atireksd11/Astra-Companion-NOISEEE/docs/README.md

# Docs

| File | Contents |
|---|---|
| [AUDIO.md](AUDIO.md) | WebSocket audio protocol and robot firmware modules |
| [VOICE_SETUP.md](VOICE_SETUP.md) | Laptop bridge, wake word, and STT |
| [ROADMAP_AUDIO.md](ROADMAP_AUDIO.md) | Full audio feature order |
| [FEATURE4_NOISE.md](FEATURE4_NOISE.md) | Noise floor and denoise |
| [FEATURE3_DOA.md](FEATURE3_DOA.md) | Direction of arrival |
| [PINOUT.md](PINOUT.md) | GPIO map including I2S |
| [images/](images/) | PCB and audio module CAD renders |

Mechanical BOM: [../hardware/BOM_AUDIO_MODULE.md](../hardware/BOM_AUDIO_MODULE.md).
