atireksd11/Astra-Companion-NOISEEE/TERRA_CONTEXT.md

# Astra Companion & Terra Project Master Context

## 1. Developer Profile & Working Style
- **Age**: 14 years old (high-school builder & programmer).
- **Primary Tools**: Cursor IDE, CAD tools (ragnar.build, zoo.dev), GitHub (`atireksd11`).
- **Work Ethic**: Intense deep-work sprints (up to 17–18 hours during weekend project blocks), structured phase-based workflows, rigorous mechanical/software engineering (CAD component envelopes, electrical docking, wire routing).
- **Schedule Constraints**: Plays cricket every Sunday from 5:00 PM to 8:00 PM. Also organizing a high-school hackathon for 50–100 participants at the University of Toronto (St. George, UTM, UTSC) on November 14–15, 2026.

---

## 2. Hack Club Terra Program & Goals
- **Program**: Hack Club Terra Software YSWS (Active: October 2026 – January 2027).
- **Target Reward**: iPad Mini (A17 Pro) to serve as a portable companion device for datasheets, schematics, and mobile notes.
- **Primary Hardware**: MSI Cyborg (heavy gaming laptop used for heavy CAD builds and local compilation).
- **Current Sprint**: Week 2. Executing a massive 20-hour manual coding sprint in VS Code / Hackatime to clear rent/debt, secure safety margins in the Terra dashboard, and maintain a pristine record.

---

## 3. Strict Compliance & Anti-AI Policy
- **Background**: Previous *Half-Life* hardware grant applications faced rejections due to AI tool usage. Admins confirmed the account is in good standing for *Terra*, but under zero-tolerance conditions.
- **Rules**: 
  - 100% manual, line-by-line human-written code only.
  - Zero AI code generation, zero AI transcription tools, zero automated prompt pasting into production codebases.
  - Hackatime telemetry must strictly mirror active human keystrokes and manual git commits.

---

## 4. Active Technical Project: Astra-Companion-NOISEEE
- **Repository**: `atireksd11/Astra-Companion-NOISEEE` (C++, Robotics / Self-Balancing AI Robot).
- **Project Scope**: Multi-phase modular robot featuring a servo-controlled neck mechanism, removable audio module enclosure, 3D-printed housing, and self-balancing mechanics.
- **Current Milestone**: Phase 0 & Phase 1 completed (bug fixes and CAD assemblies finalized). Transitioning into active software implementation for the Terra sprint.
