atireksd11/Astra-Companion-NOISEEE/docs/images/cad-pcb-stack.png

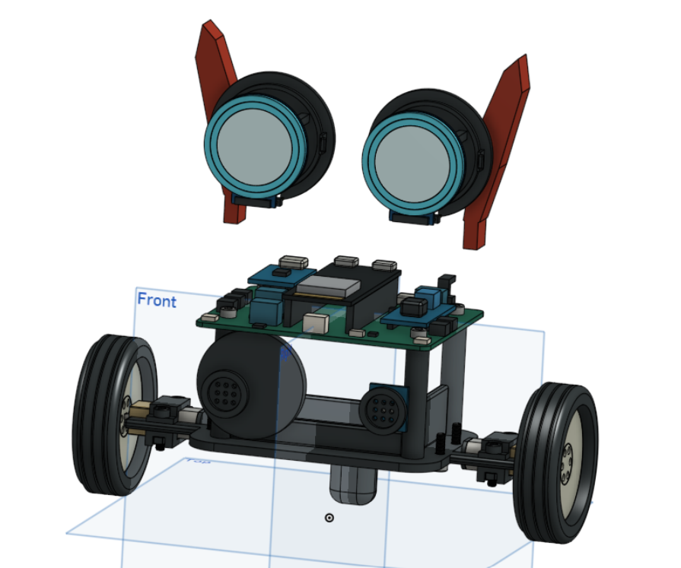
docs/images/cad-pcb-stack.png
