atireksd11/Astra-Companion-NOISEEE/BOM.csv

Item | Qty | Supplier | Cost/item | Total Cost | link
PGN 608-ZZ Ball Bearings (10-pack) | 10 | Amazon.ca | $1.295 | $12.95 | https://www.amazon.ca/gp/product/B07XLV1W2M/ref=ox_sc_act_title_2?smid=A3RMJZMAP3U4RK&psc=1
MG90S Metal Gear Micro Servo (2-pack) | 2 | Amazon.ca | $7.495 | $14.99 | https://www.amazon.ca/gp/product/B0BHYHKF2P/ref=ox_sc_act_title_1?smid=A1AEYBYG92X8UY&psc=1
Estimated total shipping | 1 |  |  | $5.00
