atireksd11/Astra-Companion-NOISEEE/cad/robot-torso-audio-backpack.step

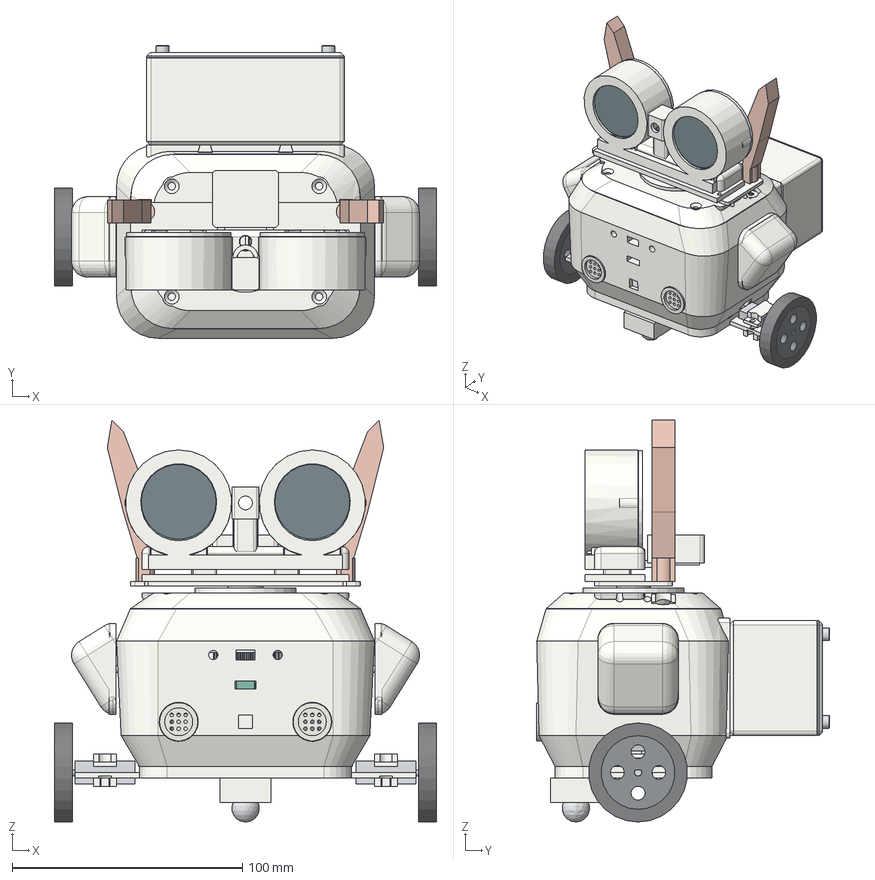
[picture p10: CAD file, 2026-10-26]
cad/robot-torso-audio-backpack.step
166.0 x 127.0 x 174.5 mm
Main torso — reinforced female docking wall
Left removable side pod
Right removable side pod
Front speaker grille
Front microphone grille
Lower chassis and battery pocket
Front frosted diffuser
Removable power and drive electronics deck
Neck service cover — cartridge opening
Front 12 mm ball caster socket
12 mm metal caster ball
TP4056 + DW01 protection — provisional PCB
MT3608 boost converter — provisional PCB
DRV8833 motor driver — provisional PCB
AP2112K 3V3 carrier — provisional PCB
MAX17048 fuel gauge carrier — provisional PCB
MAX98357A amplifier — provisional PCB
Dual bearing cartridge body
Lower bearing retaining plate
Upper bearing retainer and cover flange
Steel hollow shaft — 8 OD x 5 ID x 40
OuterRace x 2
InnerRace x 2
Cap x 4
Inner race spacer 8 mm
26T driven gear — split shaft clamp
26T servo horn gear — 1 to 1
MG90S servo — provisional supplier envelope
Offset MG90S suspended mounting frame
Purchased MG90S horn envelope — verify hole pitch
Rotating head and ear cradle — split shaft collar
Dual eye carrier — GC9A01 seats
Left eye rear cap
Right eye rear cap
Left ear
Right ear
IMU protective cover — retention fit to validate
Left GC9A01 PCB envelope
Left 1.28 inch LCD glass
Right GC9A01 PCB envelope
Right 1.28 inch LCD glass
MPU6050 PCB envelope
Left N20 upper clamp
Left N20 lower cradle
Left N20 6V 300RPM — shaft variant provisional
Left 43 mm rubber tire
Left wheel hub — 3 mm D-bore provisional
Right N20 upper clamp
Right N20 lower cradle
Right N20 6V 300RPM — shaft variant provisional
Right 43 mm rubber tire
Right wheel hub — 3 mm D-bore provisional
Audio pod base — dovetails, carriers and lock
Audio pod vented lid — six slots and four-hole grille
Speaker retention bridge
Split wire grommet — TPU or purchased equivalent
ESP32-S3 62.7 x 25.4 PCB envelope
INMP441 PCB envelope
28 mm speaker envelope
thread x 5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
