atireksd11/Astra-Companion-NOISEEE/JOURNAL.md

# Astra Companion – devlog

<!-- Generated by Half Life from project cmveqgniy09tv01rcokxzpry2. Edits here are overwritten on the next sync. -->
<!-- Generated: 2026-10-25T20:34:38.114Z -->

> [!NOTE]
> This devlog is mirrored from [Half Life](https://halflife.hackclub.com) – [open the project](https://halflife.hackclub.com/projects/cmveqgniy09tv01rcokxzpry2). Editing it here will not change the platform's copy, and the next sync overwrites this file.

> A 2-wheeler, self-balancing, smart robot powered by an ESP32-S3-DevKitC-1 module. It integrates sensor arrays (such as the MPU6050 IMU and DS3231 RTC), motor drivers (DRV8833PWP), local storage (MicroSD card), user input controls (tactile buttons and rotary encoders), and power management to create a smart robot.

| Week | Tier | Hours logged | Entries |
| --- | --- | --- | --- |
| Week 3 | Tier 1 | 19.37h | 2 |

## Contents

1. [2026-10-24 – Work session](#2026-10-24-work-session)
2. [2026-10-25 – Work session](#2026-10-25-work-session)

## Design

### 2026-10-24 – Work session

**9.05h**

[Timelapse](https://lookout.hackclub.com/api/media/45e28134-6914-488f-8e3e-f000de63a018/video.mp4)

### 2026-10-25 – Work session

**10.32h**

[Timelapse](https://lookout.hackclub.com/api/media/6f72a879-5bdd-47c9-9e10-55bd97b0e4b6/video.mp4)
