atireksd11/Astra-Companion-NOISEEE/hardware/astracompanion/astracompanion.kicad_pcb

## KiCad design hardware/astracompanion/astracompanion.kicad_pcb (2026-10-26)

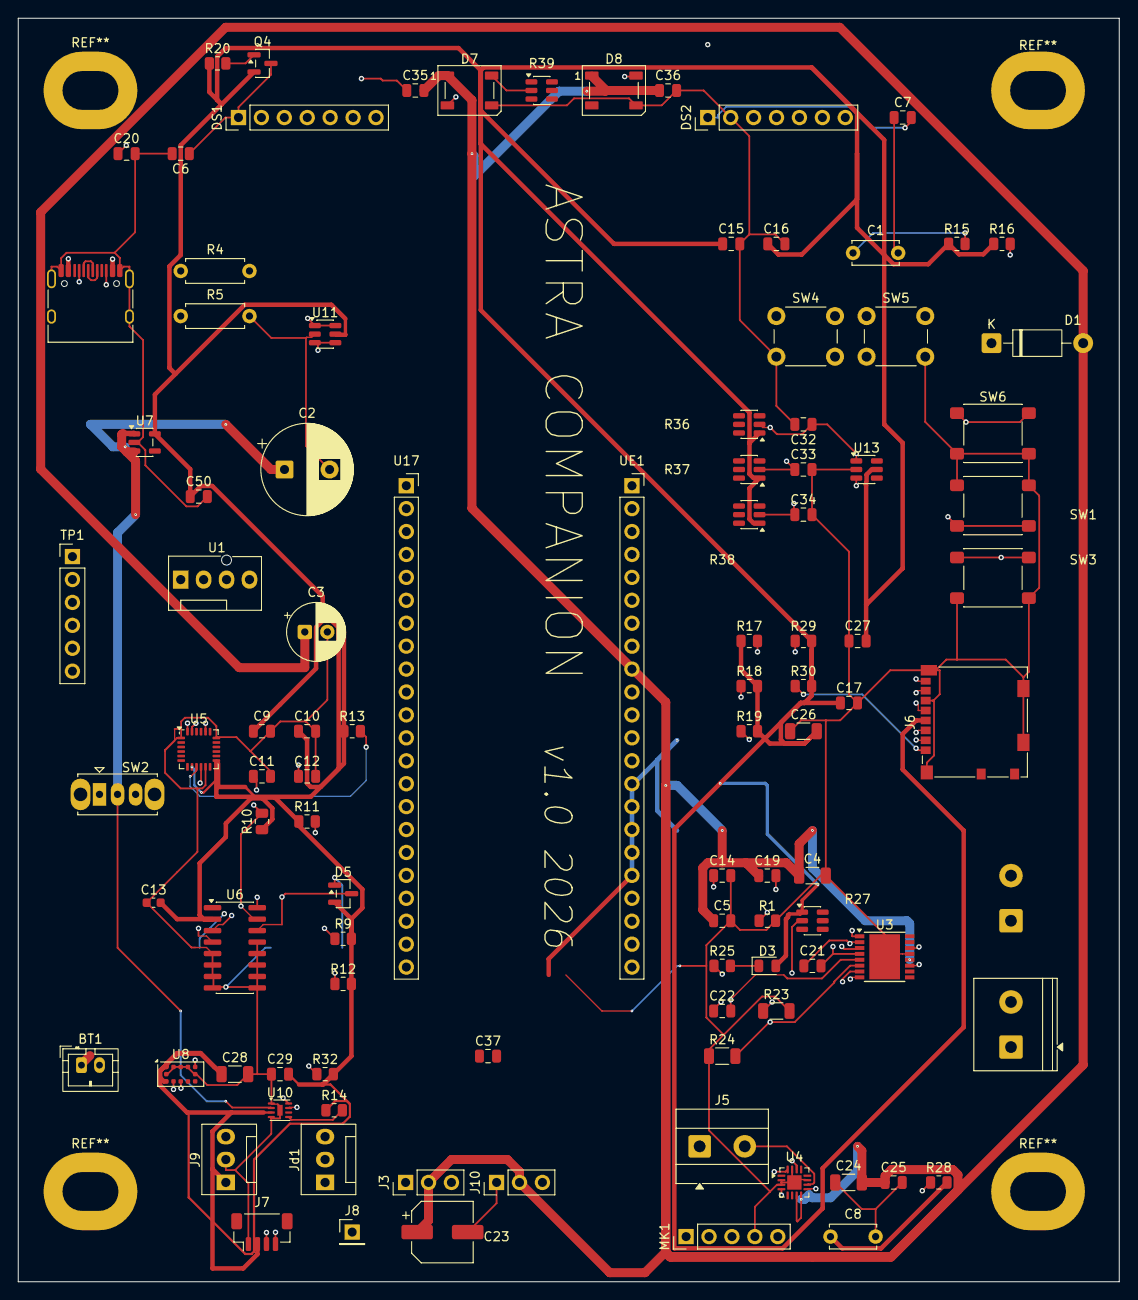
[picture p11: board astracompanion.kicad_pcb from above]

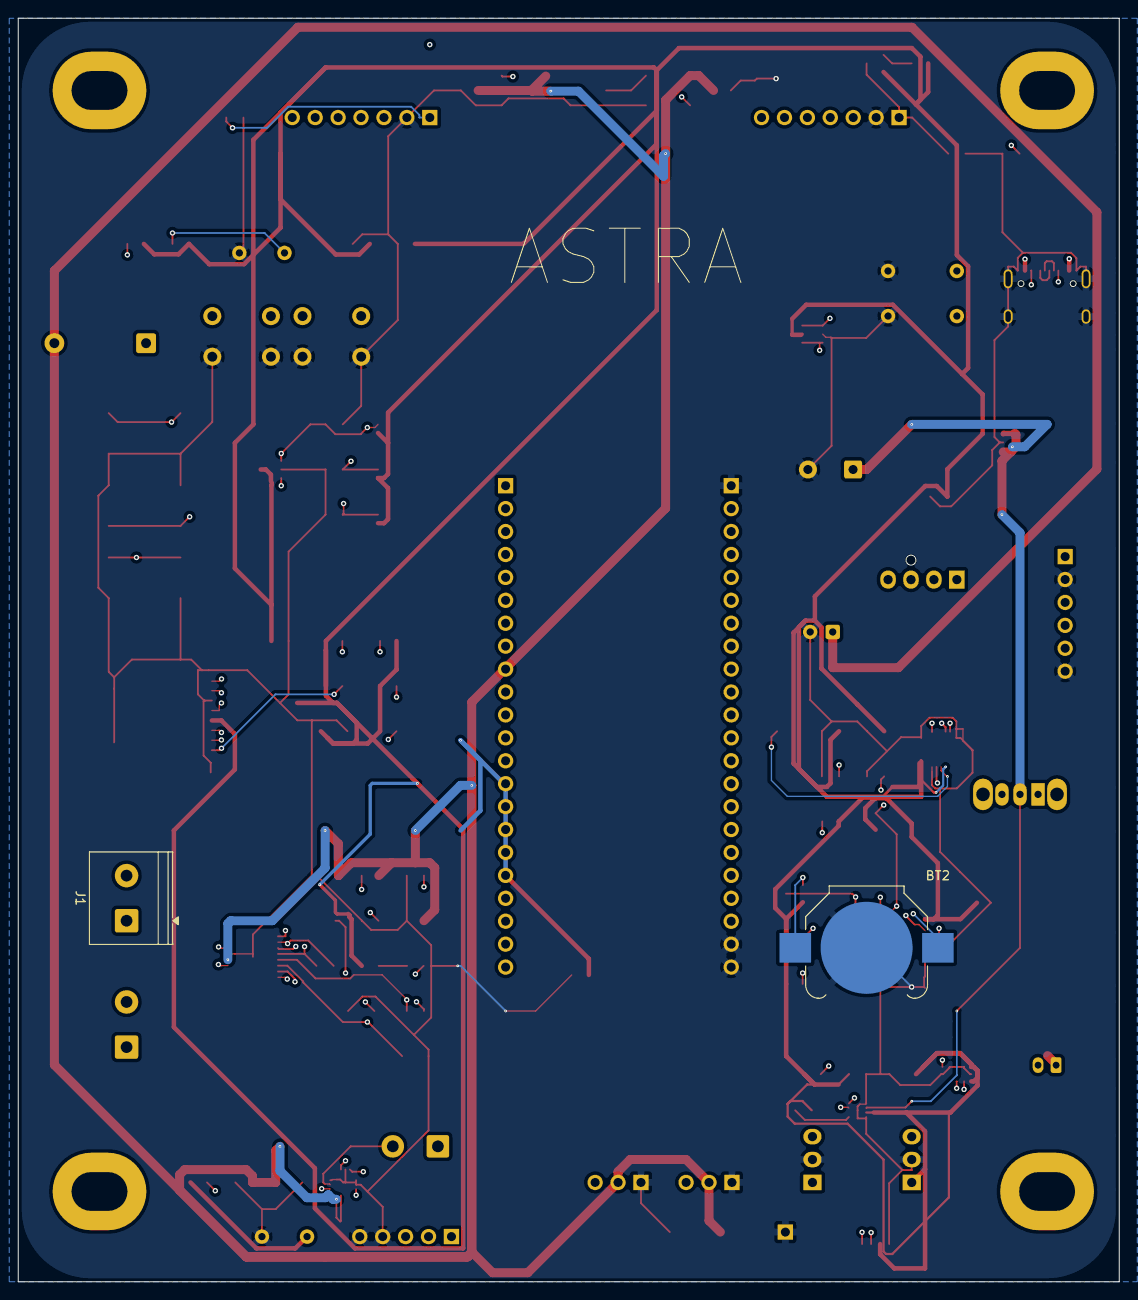
[picture p12: board astracompanion.kicad_pcb from below]

Board: 4 copper layers, 122.0 x 140.0 mm, 103 parts (2 on the bottom side), 64 nets.

Parts:
BT1: Battery_Cell; JST_PH_B2B-PH-K_1x02_P2.00mm_Vertical
BT2: Battery_Cell; BatteryHolder_Keystone_3000_1x12mm
C1: 1uF; C_Disc_D5.0mm_W2.5mm_P5.00mm
C2: 100uF; CP_Radial_D10.0mm_P5.00mm
C3: 1000uF; CP_Radial_D6.3mm_P2.50mm
C4, C24, C26, C28: 10uF; C_1206_3216Metric
C5, C6, C7, C9, C11, C16, C17, C21, C22, C25, C27, C29, C32, C33, C34, C35, C36, C37: 0.1uF; C_0805_2012Metric
C8: 0.1uF; C_Disc_D5.0mm_W2.5mm_P5.00mm
C10, C19: 10nF; C_0805_2012Metric
C12: 2.2nF; C_0805_2012Metric
C13: 0.1uF; C_0603_1608Metric
C14, C50: 2.2uF; C_0805_2012Metric
C15: 10uF; C_0805_2012Metric
C20: 22uF; C_0805_2012Metric
C23: 100uF; CP_Elec_6.3x5.4
D1: 1N5819; D_DO-41_SOD81_P10.16mm_Horizontal
D3: LED; LED_0805_2012Metric
D5: BAT54C; SOT-23
D7: WS2812B-5050; LED_WS2812B_PLCC4_5.0x5.0mm_P3.2mm
D8: WS2812B; LED_WS2812B_PLCC4_5.0x5.0mm_P3.2mm
DS1, DS2: 1.28" 240x240 LCD; PinHeader_1x07_P2.54mm_Vertical
J1, J2: Screw_Terminal_01x02; TerminalBlock_Phoenix_PT-1,5-2-5.0-H_1x02_P5.00mm_Horizontal
J3, J10: Conn_01x03_Pin; PinHeader_1x03_P2.54mm_Vertical
J4: USB_C_Receptacle_USB2.0; USB_C_Receptacle_HRO_TYPE-C-31-M-12
J5: Conn_01x02_Socket; TerminalBlock_MetzConnect_Type055_RT01502HDWU_1x02_P5.00mm_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
J6: Micro_SD_Card; microSD_HC_Molex_104031-0811
J7: Conn_01x04_Socket; JST_SH_BM04B-SRSS-TB_1x04-1MP_P1.00mm_Vertical
J8: testpoint; PinHeader_1x01_P2.54mm_Vertical
J9: Encoder_L; FanPinHeader_1x03_P2.54mm_Vertical
Jd1: Encoder_R; FanPinHeader_1x03_P2.54mm_Vertical
MK1: INMP441ACEZ-R7; PinHeader_1x05_P2.54mm_Vertical
Q4: AO3401A; SOT-23
R1, R9, R12, R13, R14, R15, R16, R17, R18, R19, R20, R29, R30, R32: 10k; R_0805_2012Metric
R4, R5: 5.1K; R_Axial_DIN0207_L6.3mm_D2.5mm_P7.62mm_Horizontal
R10, R11: 2.2k; R_0805_2012Metric
R23, R24: 0.2; R_1206_3216Metric
R25: 1k; R_0805_2012Metric
R27, R36, R37, R38: 10k; SOT-23-6
R28: 100k; R_0805_2012Metric
R39: 330; SOT-23-6
SW1, SW3, SW6: PTS645; SW_SPST_PTS645Sx43SMTR92
SW2: SW_SPST; SW_Slide_SPDT_Straight_CK_OS102011MS2Q
SW4: Reset / EN button; SW_PUSH_6mm
SW5: Boot / IO0 button; SW_PUSH_6mm
TP1: PinHeader_1x06_P2.54mm_Vertical
U1: MT3608_BOOSTER_MODULE; FanPinHeader_1x04_P2.54mm_Vertical
U3: DRV8833PWP; HTSSOP-16-1EP_4.4x5mm_P0.65mm_EP3.4x5mm
U4: MAX98357A; TQFN-16-1EP_3x3mm_P0.5mm_EP1.6x1.6mm
U5: MPU-6050; InvenSense_QFN-24_4x4mm_P0.5mm
U6: DS3231M; SOIC-16_3.9x9.9mm_P1.27mm
U7: AP2112K-3.3; SOT-23-5
U8: VL53L0CXV0DH1; ST_VL53L1x
U10: MAX17048G+T10; DFN-8-1EP_2x2mm_P0.5mm_EP0.6x1.2mm
U11: USBLC6-2SC6; SOT-23-6
U13: USBLC6-4SC6; SOT-23-6
U17: Conn_01x22_Pin; PinSocket_1x22_P2.54mm_Vertical
UE1: Conn_01x22_Pin; PinSocket_1x22_P2.54mm_Vertical

Connections:
+3V3: C8.1, C9.1, C10.1, C13.2, C15.1, C16.1, C17.1, C26.2, C27.2, C28.1, C29.2, C37.1, C50.1, D3.2 (A), D5.2, J6.4 (VDD), J7.2, J9.1, Jd1.1, Q4.2 (S), R9.2, R10.1, R11.1, R12.2, R13.1, R14.1, R15.1, R16.1, R17.1, R18.2, R19.2, R20.1, R27.1, R28.2, R29.2, R30.2, R32.2, R36.1, R37.1, R38.1, U5.8 (VLOGIC), U5.13 (VDD), U6.2 (VCC), U7.5 (VOUT), U8.1 (AVDDVCSEL), U8.11 (AVDD), U10.3 (VDD), U11.5 (VBUS), U13.5 (VBUS)
+3V3_DISP: C6.1, C7.2, C20.1, DS1.1 (VCC), DS2.1 (VCC), Q4.3 (D)
+5V: C3.1, C4.1, C5.1, C19.1, C23.1, C24.2, C25.1, C35.2, C36.1, D1.2 (A), D7.1 (VDD), D8.1 (VDD), J3.2, J10.2, U3.12 (VM), U4.7 (VDD), U4.8 (VDD)
/B-: BT1.2 (-), TP1.4 (B-)
B+: BT1.1 (+), TP1.3 (B+)
BTN_DOWN: C34.1, R38.2, SW6.1
BTN_SELECT: U13.4 (I/O3), U17.5
BTN_UP: U13.6 (I/O4), U17.4
DISP_PWR_EN: Q4.1 (G), R20.2
ESP_RST: C1.1, DS1.7 (RST), DS2.7 (RST), R15.2, SW4.1
FG_INT: R14.2, U10.5 (~ALRT)
GND: BT2.2 (-), C1.2, C2.2, C3.2, C4.2, C5.2, C6.2, C7.1, C8.2, C9.2, C10.2, C11.2, C12.2, C13.1, C14.2, C15.2, C16.2, C17.2, C20.2, C23.2, C24.1, C25.2, C26.1, C27.1, C28.2, C29.1, C32.2, C33.2, C34.2, C35.1, C36.2, C37.2, C50.2, D7.3 (VSS), D8.3 (VSS), DS1.2 (GND), DS2.2 (GND), J3.1, J4.A1 (GND), J4.A12 (GND), J4.B1 (GND), J4.B12 (GND), J4.SH (SHIELD), J6.6 (VSS), J6.SH (SHIELD), J7.1, J8.1 (Pin_1_1), J9.2, J10.1, Jd1.2, MK1.4 (L/R), MK1.5 (GND), R1.2, R4.2, R5.2, R23.2, R24.1, SW1.2, SW3.2, SW4.2, SW5.2, SW6.2, TP1.2 (-), TP1.6 (OUT-), U3.13 (GND), U3.17 (GND), U4.2 (GAIN_SLOT), U4.3 (GND), U4.11 (GND), U4.15 (GND), U4.17 (PAD), U5.1 (CLKIN), U5.11 (FSYNC), U5.18 (GND), U6.5 (GND), U6.6 (GND), U6.7 (GND), U6.8 (GND), U6.9 (GND), U6.10 (GND), U6.11 (GND), U6.12 (GND), U6.13 (GND), U7.2 (GND), U8.2 (AVSSVCSEL), U8.3 (GND), U8.4 (GND), U8.6 (GND), U8.12 (GND), U10.1 (CTG), U10.4 (GND), U10.9 (EP), U11.2 (GND), U13.2 (GND), U17.1, U17.21, U17.22
I2C_SCL: J7.4, R11.2, U5.23 (SCL), U6.16 (SCL), U8.10 (SCL), U10.7 (SCL), U11.3 (I/O2), U11.4 (I/O2)
I2C_SDA: J7.3, R10.2, U5.24 (SDA), U6.15 (SDA), U8.9 (SDA), U10.8 (SDA), U11.1 (I/O1), U11.6 (I/O1)
I2S_BCLK: MK1.1 (SCK), U4.16 (BCLK), U17.15
I2S_DOUT: U4.1 (DIN), U17.2
I2S_LRCK: MK1.3 (WS), U4.14 (LRCLK), U17.16
MOTOR_L_DIR: U3.9 (BIN1), U17.8
MOTOR_L_PWM: U3.10 (BIN2), U17.9
MOTOR_R_DIR: U3.16 (AIN1), U17.6
MOTOR_R_PWM: U3.15 (AIN2), U17.7
M_FAULT: R25.1, R27.2, U3.8 (~FAULT)
M_SLP: R1.1, U3.1 (~SLEEP)
unnamed: BT2.1 (+), D5.1
unnamed: D3.1 (K), R25.2
unnamed: D7.4 (DIN), R39.2
unnamed: D7.2 (DOUT), D8.4 (DIN)
unnamed: C21.1, J1.1, U3.2 (AOUT1)
unnamed: C21.2, J1.2, U3.4 (AOUT2)
unnamed: C22.1, J2.1, U3.7 (BOUT1)
unnamed: C22.2, J2.2, U3.5 (BOUT2)
unnamed: J4.A5 (CC1), R4.1
unnamed: J4.B5 (CC2), R5.1
unnamed: J5.1, U4.9 (OUTP)
unnamed: J5.2, U4.10 (OUTN)
unnamed: J6.8 (DAT1), R29.1
unnamed: J6.1 (DAT2), R30.1
unnamed: R23.1, U3.3 (AISEN)
unnamed: R24.2, U3.6 (BISEN)
unnamed: C19.2, U3.11 (VCP)
unnamed: C14.1, U3.14 (VINT)
unnamed: R28.1, U4.4 (~SD_MODE)
unnamed: R13.2, U5.9 (AD0)
unnamed: C12.1, U5.20 (CPOUT)
unnamed: C11.1, U5.10 (REGOUT)
unnamed: D5.3, U6.14 (VBAT)
unnamed: R9.1, U6.4 (~RST)
unnamed: C32.1, R36.2, SW1.1, U13.1 (I/O1)
unnamed: C33.1, R37.2, SW3.1, U13.3 (I/O2)
unnamed: R16.2, SW5.1, U17.14
OUT+: SW2.1 (A), TP1.5 (OUT+)
RGB_DATA: R39.1, U17.10
RTC_INT: R12.1, U6.3 (~INT/SQW)
SD_CS: J6.2 (DAT3/CD), R19.1, U17.18
SERVO_PWM: J3.3, J10.3
SPI_CLK: DS1.3 (SCL), DS2.3 (SCL), J6.5 (CLK)
SPI_MISO: J6.7 (DAT0), R18.1, U17.17
SPI_MOSI: DS1.4 (SDA), DS2.4 (SDA), J6.3 (CMD), R17.2
TFT_DC: DS1.5 (DC), DS2.5 (DC)
TOF_XSHUT: R32.1, U8.5 (XSHUT)
USB_D+: J4.A6 (D+), J4.B6 (D+), U17.19
USB_D-: J4.A7 (D-), J4.B7 (D-), U17.20
VBAT: C2.1, SW2.2 (B), U7.1 (VIN), U7.3 (EN), U10.2 (CELL)
VBUS: J4.A4 (VBUS), J4.A9 (VBUS), J4.B4 (VBUS), J4.B9 (VBUS), TP1.1 (5V+)
