atireksd11/Astra-Companion-NOISEEE/(commit log)

2026-10-26 Initial push: audio module BOM, docs, and KiCad carrier PCB.
    Mechanical neck and speaker parts, PCB schematic/layout, and audio/noise design notes for Half Life week.
    [astracompanion.kicad_pcb, astracompanion.kicad_sch, bom-audio-module.csv, bom.csv]
2026-10-26 Add ESP32 PlatformIO firmware (C++).
    Listener, I2S audio, and bridge client for the carrier board. Wi-Fi secrets stay in the gitignored example copy.
2026-10-26 Sync Astra Companion from Half Life
    [BOM.csv]
2026-10-26 Drop the neck shaft tube and add Amazon unit prices.
    [bom-audio-module.csv]
2026-10-26 Put bearing and MG90S unit prices and Amazon links in BOM.csv.
    [BOM.csv]
2026-10-26 Add the torso audio backpack STEP export.
    [robot-torso-audio-backpack.step]
